rhinocerose/eurorack-jakplugg-nRings/NanoRings BOM 1.0.xlsx

Sheet: Sheet1
Quantity | Value | RefDes | Name | Mouser | Other | Notes
6 | 18p | C4, C5, C23, C24, C42, C43 | C-USC0603 | 81-GRM185C1H180JA01J
1 | 220p | C49 | C-USC0603 | 81-GRM185C1H221GA01D
2 | 2.2n | C14, C29 | C-USC0603 | 81-GRM1885C1H222JA1J
4 | 10n | C26, C28, C36, C38 | C-USC0603 | 81-GRM18R71H103JA01D
20 | 100n | C6, C9, C10, C11, C13, C15, C17, C19, C20, C25, C27, C31, C35, C37, C39, C44, C45, C47, C48, C50 | C-USC0603 | 81-GRM188R71E104JA1J
3 | 1u | C7, C18, C30 | C-USC0603 | 81-GRM18R61A105KA61J
2 | 2.2u | C16, C22 | C-USC0805 | 810-C2012X5R1A225K-2
8 | 10u | C12, C21, C32, C33, C34, C40, C41, C46 | CPOL-USA | 647-UWX1C100MCL2
1 | 22u | C1 | CPOL-USC | 667-EEE-FP1E220AR
3 | 47u | C2, C3, C8 | CPOL-USD | 667-EEE-FT1V470AR
1 | 4.7 | R2 | R-US_R1206 | 603-RC1206JR-074R7L (https://www.mouser.com/ProductDetail/Yageo/RC1206JR-074R7L/)
4 | 180 | R1, R3, R4, R5 | R-US_R0603 | 603-RC0603FR-07180RL (http://www.mouser.com/ProductDetail/Yageo/RC0603FR-07180RL/?qs=sGAEpiMZZMu61qfTUdNhG5eFuApKbqVd4SzxXNqyudw%3d)
2 | 1.0k | R55, R56 | R-US_R0603 | 603-RC0603FR-071KL (http://www.mouser.com/Search/ProductDetail.aspx)
3 | 2.2k | R12, R16, R17 | R-US_R0603 | 603-RC0603FR-072K2L (http://www.mouser.com/ProductDetail/Yageo/RC0603FR-072K2L/)
3 | 6.8k | R40, R43, R51 | R-US_R0603 | 603-RC0603FR-076K8L (http://www.mouser.com/Search/ProductDetail.aspx)
3 | 10k | R6, R7, R8 | R-US_R0603 | 603-RC0603FR-0710KL (http://www.mouser.com/ProductDetail/Yageo/RC0603FR-0710KL/?qs=sGAEpiMZZMu61qfTUdNhGy0AaN4GKk3uV0uhGqAFOnk%3d)
5 | 20k | R18, R25, R26, R31, R32 | R-US_R0603 | 603-RC0603FR-0720KL (http://www.mouser.com/ProductDetail/Yageo/RC0603FR-0720KL/)
2 | 36k | R27, R54 | R-US_R0603 | 603-RC0603FR-0736KL (http://www.mouser.com/ProductDetail/Yageo/RC0603FR-0736KL)
7 | 47k | R13, R33, R38, R39, R41, R42, R44 | R-US_R0603 | 603-RC0603FR-0747KL (http://www.mouser.com/Search/ProductDetail.aspx)
8 | 100k | R11, R14, R19, R21, R22, R34, R35, R52 | R-US_R0603 | 603-RC0603FR-07100KL (http://www.mouser.com/Search/ProductDetail.aspx)
5 | 120k | R20, R23, R24, R36, R37 | R-US_R0603 | 603-RC0603FR-07120KL (http://www.mouser.com/ProductDetail/Yageo/RC0603FR-07120KL/?qs=sGAEpiMZZMu61qfTUdNhG6gKAQVNBKOoUjxHZ2IMUOI%3d)
1 | 180k | R15 | R-US_R0603 | 603-RC0603FR-07180KL (http://www.mouser.com/ProductDetail/Yageo/RC0603FR-07180KL)
1 | 470k | R57 | R-US_R0603 | 603-RC0603FR-07470KL (http://www.mouser.com/ProductDetail/Yageo/RC0603FR-07470KL/)
1 | 1M | R53 | R-US_R0603 | 603-RC0603FR-071ML (http://www.mouser.com/ProductDetail/Yageo/RC0603FR-071ML/?qs=sGAEpiMZZMu61qfTUdNhG5eFuApKbqVd5YtEsnCb1iw%3d)
1 | 3.3M | R50 | R-US_R0603 | RC0603FR-073M3L (http://www.mouser.com/ProductDetail/Yageo/RC0603FR-073M3L/)
5 | 10kB | R45, R46, R47, R48, R49 | POT_USVERTICAL | Sung Huei Short
5 | 10kB | R9, R10, R28, R29, R30 | POT_USVERTICAL_PS | Sung Huei Long
1 | BAT54S | D3 | DIODE_2CACA-SOT23 | 512-BAT54S
1 | MB1S | D7 | MB1S | 512-MB1S
1 | LM1117-3.3 | IC1 | REG1117T | 926-LM1117MPX3.3NOPB
1 | STM32F405RGT6 | IC2 | STM32F20X | 511-STM32F405RGT6
1 | LM4040B10 | IC3 | LM4041B12DBZ | 595-LM4040C10IDBZR
1 | 4051PW | IC4 | 4051PW | 595-CD4051BPWR
3 | MCP6002 | IC5, IC7, IC9 | SOIC8 | 579-MCP6002-I/SN
1 | WM8731 | IC6 | WM8731 | 238-WM8731SEDS/V
1 | TL072 | IC8 | SOIC8 | 595-TL072CD
3 |  | L1, L2, L3 | WE-CBF_0603 | 710-742792642
2 | WP115VEGW | LED1, LED2 | LED-BICOLOR-TH | 604-WP115VEGW
1 | 8MHz | Q1 | TSC 7A crystal | 717-7A-8.000MAAJ-T
1 | MMBT3904 | Q2 | MMBT3904 | 863-MMBT3904LT1G
1 | 12.288MHz | Q3 | TSC 7A crystal | 717-7A-12.288MAAJ-T
2 |  | SW1, SW2 | TAC_SWITCHPTH | 612-TL1105SP-250
2 |  |  | Cap for switch | 612-1R-BK
10 | PJ301 | J1, J2, J3, J4, J5, J6, J7, J8. J9, J10
1 | SOLDERJUMPERNC2 | SJ1 | SOLDERJUMPERNC2
1 | M05X2MINIJTAG | JP1 | M05X2MINIJTAG
1 | M05X2PTH | JP3 | M05X2PTH

Sheet: rangoon
Quantity | Value | RefDes | Name | Mouser | Other | Notes
6 | 18p | C4, C5, C23, C24, C42, C43 | C-USC0603 | 81-GRM185C1H180JA01J
1 | 220p | C49 | C-USC0603 | 81-GRM185C1H221GA01D
2 | 2.2n | C14, C29 | C-USC0603 | 81-GRM1885C1H222JA1J
4 | 10n | C26, C28, C36, C38 | C-USC0603 | 81-GRM18R71H103JA01D
20 | 100n | C6, C9, C10, C11, C13, C15, C17, C19, C20, C25, C27, C31, C35, C37, C39, C44, C45, C47, C48, C50 | C-USC0603 | 81-GRM188R71E104JA1J
3 | 1u | C7, C18, C30 | C-USC0603 | 81-GRM18R61A105KA61J
2 | 2.2u | C16, C22 | C-USC0805 | 810-C2012X5R1A225K-2
8 | 10u | C12, C21, C32, C33, C34, C40, C41, C46 | CPOL-USA | 647-UWX1C100MCL2
1 | 22u | C1 | CPOL-USC | 667-EEE-FP1E220AR
3 | 47u | C2, C3, C8 | CPOL-USD | 667-EEE-FT1V470AR
1 | 4.7 | R2 | R-US_R1206 | 603-RC1206JR-074R7L (https://www.mouser.com/ProductDetail/Yageo/RC1206JR-074R7L/)
4 | 180 | R1, R3, R4, R5 | R-US_R0603 | 603-RC0603FR-07180RL (http://www.mouser.com/ProductDetail/Yageo/RC0603FR-07180RL/?qs=sGAEpiMZZMu61qfTUdNhG5eFuApKbqVd4SzxXNqyudw%3d)
2 | 1.0k | R55, R56 | R-US_R0603 | 603-RC0603FR-071KL (http://www.mouser.com/Search/ProductDetail.aspx)
3 | 2.2k | R12, R16, R17 | R-US_R0603 | 603-RC0603FR-072K2L (http://www.mouser.com/ProductDetail/Yageo/RC0603FR-072K2L/)
3 | 6.8k | R40, R43, R51 | R-US_R0603 | 603-RC0603FR-076K8L (http://www.mouser.com/Search/ProductDetail.aspx)
3 | 10k | R6, R7, R8 | R-US_R0603 | 603-RC0603FR-0710KL (http://www.mouser.com/ProductDetail/Yageo/RC0603FR-0710KL/?qs=sGAEpiMZZMu61qfTUdNhGy0AaN4GKk3uV0uhGqAFOnk%3d)
5 | 20k | R18, R25, R26, R31, R32 | R-US_R0603 | 603-RC0603FR-0720KL (http://www.mouser.com/ProductDetail/Yageo/RC0603FR-0720KL/)
2 | 36k | R27, R54 | R-US_R0603 | 603-RC0603FR-0736KL (http://www.mouser.com/ProductDetail/Yageo/RC0603FR-0736KL)
7 | 47k | R13, R33, R38, R39, R41, R42, R44 | R-US_R0603 | 603-RC0603FR-0747KL (http://www.mouser.com/Search/ProductDetail.aspx)
8 | 100k | R11, R14, R19, R21, R22, R34, R35, R52 | R-US_R0603 | 603-RC0603FR-07100KL (http://www.mouser.com/Search/ProductDetail.aspx)
5 | 120k | R20, R23, R24, R36, R37 | R-US_R0603 | 603-RC0603FR-07120KL (http://www.mouser.com/ProductDetail/Yageo/RC0603FR-07120KL/?qs=sGAEpiMZZMu61qfTUdNhG6gKAQVNBKOoUjxHZ2IMUOI%3d)
1 | 180k | R15 | R-US_R0603 | 603-RC0603FR-07180KL (http://www.mouser.com/ProductDetail/Yageo/RC0603FR-07180KL)
1 | 470k | R57 | R-US_R0603 | 603-RC0603FR-07470KL (http://www.mouser.com/ProductDetail/Yageo/RC0603FR-07470KL/)
1 | 1M | R53 | R-US_R0603 | 603-RC0603FR-071ML (http://www.mouser.com/ProductDetail/Yageo/RC0603FR-071ML/?qs=sGAEpiMZZMu61qfTUdNhG5eFuApKbqVd5YtEsnCb1iw%3d)
1 | 3.3M | R50 | R-US_R0603 | RC0603FR-073M3L (http://www.mouser.com/ProductDetail/Yageo/RC0603FR-073M3L/)
5 | 10kB | R9, R10, R28, R29, R30 | POT_USVERTICAL_PS | Sung Huei Long
5 | 10kB | R45, R46, R47, R48, R49 | POT_USVERTICAL | Sung Huei Short
4 | 10kB |  | 30mm LED slider
1 | BAT54S | D3 | DIODE_2CACA-SOT23 | 512-BAT54S
1 | MB1S | D7 | MB1S | 512-MB1S
1 | LM1117-3.3 | IC1 | REG1117T | 926-LM1117MPX3.3NOPB
1 | STM32F405RGT6 | IC2 | STM32F20X | 511-STM32F405RGT6
1 | LM4040B10 | IC3 | LM4041B12DBZ | 595-LM4040C10IDBZR
1 | 4051PW | IC4 | 4051PW | 595-CD4051BPWR
3 | MCP6002 | IC5, IC7, IC9 | SOIC8 | 579-MCP6002-I/SN
1 | WM8731 | IC6 | WM8731 | 238-WM8731SEDS/V
1 | TL072 | IC8 | SOIC8 | 595-TL072CD
3 |  | L1, L2, L3 | WE-CBF_0603 | 710-742792642
2 | WP115VEGW | LED1, LED2 | LED-BICOLOR-TH | 604-WP115VEGW
1 | 8MHz | Q1 | TSC 7A crystal | 717-7A-8.000MAAJ-T
1 | MMBT3904 | Q2 | MMBT3904 | 863-MMBT3904LT1G
1 | 12.288MHz | Q3 | TSC 7A crystal | 717-7A-12.288MAAJ-T
2 |  | SW1, SW2 | TAC_SWITCHPTH | 612-TL1105SP-250
2 |  |  | Cap for switch | 612-1R-BK
10 | PJ301 | J1, J2, J3, J4, J5, J6, J7, J8. J9, J10
1 | SOLDERJUMPERNC2 | SJ1 | SOLDERJUMPERNC2
1 | M05X2MINIJTAG | JP1 | M05X2MINIJTAG
1 | M05X2PTH | JP3 | M05X2PTH
