rhinocerose/eurorack-jakplugg-nRings/(list of files, drawings)

Other design files:
nrings/board-files/diptrace/nRings.dch
nrings/board-files/diptrace/nRings.dip
nrings/panel/nRings_panel.dip
rangoon/board-files/diptrace/rangoon.dch
rangoon/board-files/diptrace/rangoon.dip
rangoon/panel/PCB_panel_basic/rangoon_panel_plugg.dip
rangoon/panel/rangoon_panel_plugg.dip
