rhinocerose/eurorack-jakplugg-nRings/nrings/board-files/kicad/nrings.kicad_pcb

## KiCad design nrings/board-files/kicad/nrings.kicad_pcb (2025-08-07)

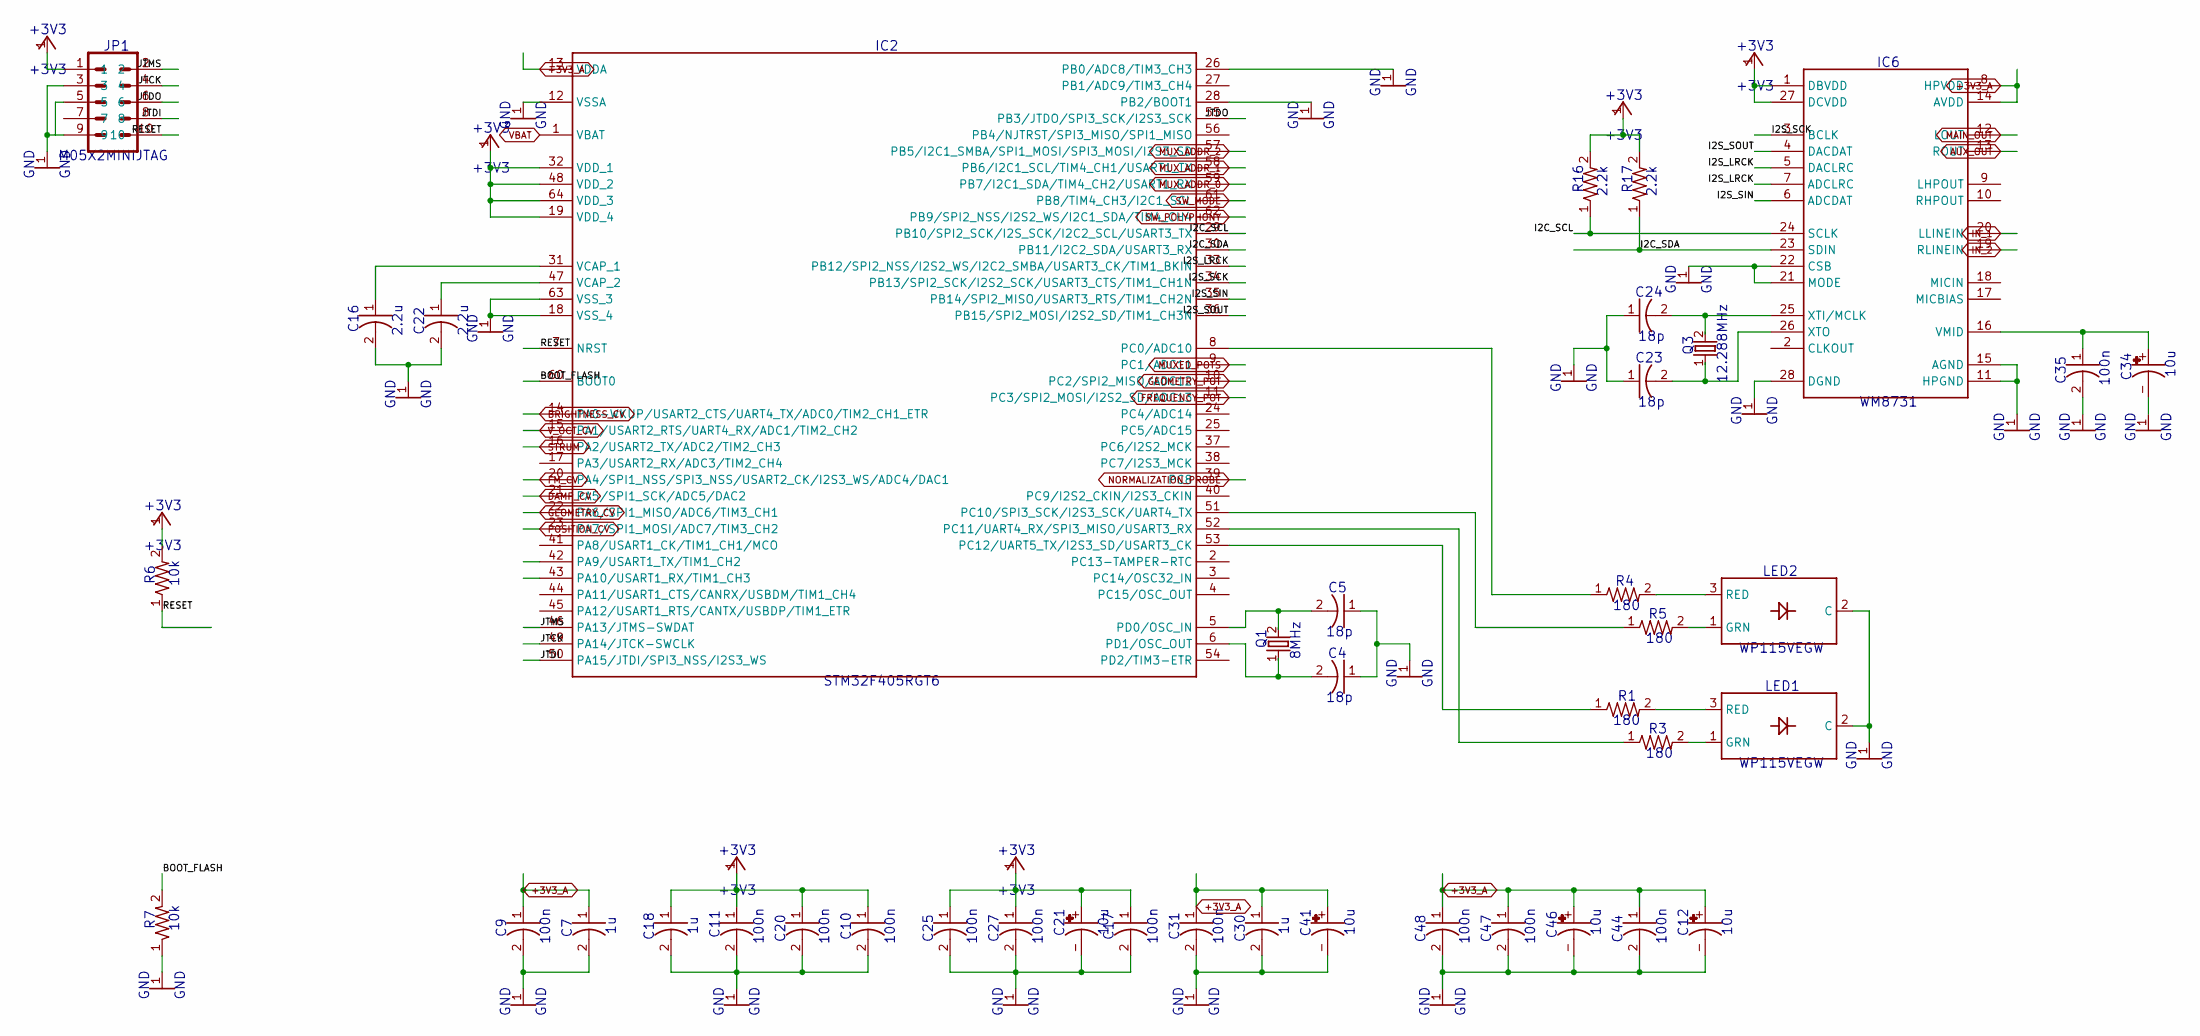
[picture p1: schematic Sheet1.kicad_sch]

Parts:
C4, C5, C23, C24: 18p; CAP_0603
C7, C18, C30: 1u; CAP_0603
C9, C10, C11, C17, C20, C25, C27, C31, C35, C44, C47, C48: 100n; CAP_0603
C12, C21, C34, C41, C46: 10u; PANASONIC_A
C16, C22: 2.2u; CAP_0805
IC2: STM32F405RGT6; TQFP-10X10-64
IC6: WM8731; SSOP28
JP1: M05X2MINIJTAG; 2X5-1.27
LED1, LED2: WP115VEGW; LED-BICOLOR-THROUGHHOLE
Q1: 8MHz; TSC_7A_CRYSTAL
Q3: 12.288MHz; TSC_7A_CRYSTAL
R1, R3, R4, R5: 180; RES_0603
R6, R7: 10k; RES_0603
R16, R17: 2.2k; RES_0603

Connections:
+3V3: C10.1, C11.1, C17.1, C18.1, C20.1, C21.+, C25.1, C27.1, IC2.19 (VDD_4), IC2.32 (VDD_1), IC2.48 (VDD_2), IC2.64 (VDD_3), IC6.1 (DBVDD), IC6.27 (DCVDD), JP1.1, R6.2, R16.2, R17.2; also elsewhere on the board
+3V3_A: C7.1, C9.1, C12.+, C30.1, C31.1, C41.+, C44.1, C46.+, C47.1, C48.1, IC2.13 (VDDA), IC6.8 (HPVDD), IC6.14 (AVDD); also elsewhere on the board
AUX_OUT: IC6.13 (ROUT); also elsewhere on the board
BOOT_FLASH: IC2.60 (BOOT0), R7.2
BRIGHTNESS_CV: IC2.14 (PA0-WKUP/USART2_CTS/UART4_TX/ADC0/TIM2_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); also elsewhere on the board
DAMP_CV: IC2.21 (PA5/SPI1_SCK/ADC5/DAC2); also elsewhere on the board
FM_CV: IC2.20 (PA4/SPI1_NSS/SPI3_NSS/USART2_CK/I2S3_WS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); also elsewhere on the board
FREQUENCY_POT: IC2.11 (PC3/SPI2_MOSI/I2S2_SD/ADC13); also elsewhere on the board
GEOMETRY_CV: IC2.22 (PA6/SPI1_MISO/ADC6/TIM3_CH1); also elsewhere on the board
GEOMETRY_POT: IC2.10 (PC2/SPI2_MISO/ADC12); also elsewhere on the board
GND: C4.1, C5.1, C7.2, C9.2, C10.2, C11.2, C12.-, C16.2, C17.2, C18.2, C20.2, C21.-, C22.2, C23.1, C24.1, C25.2, C27.2, C30.2, C31.2, C34.-, C35.2, C41.-, C44.2, C46.-, C47.2, C48.2, IC2.12 (VSSA), IC2.18 (VSS_4), IC2.26 (PB0/ADC8/TIM3_CH3), IC2.28 (PB2/BOOT1), IC2.63 (VSS_3), IC6.11 (HPGND), IC6.15 (AGND), IC6.21 (MODE), IC6.22 (CSB), IC6.28 (DGND), JP1.3, JP1.5, JP1.9, LED1.2 (C), LED2.2 (C), R7.1; also elsewhere on the board
I2C_SCL: IC2.29 (PB10/SPI2_SCK/I2S_SCK/I2C2_SCL/USART3_TX), IC6.24 (SCLK), R16.1
I2C_SDA: IC2.30 (PB11/I2C2_SDA/USART3_RX), IC6.23 (SDIN), R17.1
I2S_LRCK: IC2.33 (PB12/SPI2_NSS/I2S2_WS/I2C2_SMBA/USART3_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), IC6.5 (DACLRC), IC6.7 (ADCLRC)
I2S_SCK: IC2.34 (PB13/SPI2_SCK/I2S2_SCK/USART3_CTS/TIM1_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), IC6.3 (BCLK)
I2S_SIN: IC2.35 (PB14/SPI2_MISO/USART3_RTS/TIM1_CH2N), IC6.6 (ADCDAT)
I2S_SOUT: IC2.36 (PB15/SPI2_MOSI/I2S2_SD/TIM1_CH3N), IC6.4 (DACDAT)
IN_1: IC6.20 (LLINEIN); also elsewhere on the board
IN_2: IC6.19 (RLINEIN); also elsewhere on the board
JTCK: IC2.49 (PA14/JTCK-SWCLK), JP1.4
JTDI: IC2.50 (PA15/JTDI/SPI3_NSS/I2S3_WS), JP1.8
JTDO: IC2.55 (PB3/JTDO/SPI3_SCK/I2S3_SCK), JP1.6
JTMS: IC2.46 (PA13/JTMS-SWDAT), JP1.2
MAIN_OUT: IC6.12 (LOUT); also elsewhere on the board
MUXED_POTS: IC2.9 (PC1/ADC11); also elsewhere on the board
MUX_ADDR_0: IC2.59 (PB7/I2C1_SDA/TIM4_CH2/USART1_RX); also elsewhere on the board
MUX_ADDR_1: IC2.58 (PB6/I2C1_SCL/TIM4_CH1/USART1_TX); also elsewhere on the board
MUX_ADDR_2: IC2.57 (PB5/I2C1_SMBA/SPI1_MOSI/SPI3_MOSI/I2S3_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); also elsewhere on the board
unnamed: C5.2, IC2.5 (PD0/OSC_IN), Q1.2
unnamed: C4.2, IC2.6 (PD1/OSC_OUT), Q1.1
unnamed: LED1.3 (RED), R1.2
unnamed: C22.1, IC2.47 (VCAP_2)
unnamed: C34.+, C35.1, IC6.16 (VMID)
unnamed: C16.1, IC2.31 (VCAP_1)
unnamed: LED1.1 (GRN), R3.2
unnamed: LED2.3 (RED), R4.2
unnamed: LED2.1 (GRN), R5.2
unnamed: IC2.52 (PC11/UART4_RX/SPI3_MISO/USART3_RX), R3.1
unnamed: IC2.8 (PC0/ADC10), R4.1
unnamed: C24.2, IC6.25 (XTI/MCLK), Q3.2
unnamed: C23.2, IC6.26 (XTO), Q3.1
unnamed: IC2.53 (PC12/UART5_TX/I2S3_SD/USART3_CK), R1.1
unnamed: IC2.51 (PC10/SPI3_SCK/I2S3_SCK/UART4_TX), R5.1
NORMALIZATION_PROBE: IC2.39 (PC8); also elsewhere on the board
POSITION_CV: IC2.23 (PA7/SPI1_MOSI/ADC7/TIM3_CH2); also elsewhere on the board
RESET: IC2.7 (NRST), JP1.10, R6.1
STRUM: IC2.16 (PA2/USART2_TX/ADC2/TIM2_CH3); also elsewhere on the board
SW_MODE: IC2.61 (PB8/TIM4_CH3/I2C1_SCL); also elsewhere on the board
SW_POLYPHONY: IC2.62 (PB9/SPI2_NSS/I2S2_WS/I2C1_SDA/TIM4_CH4); also elsewhere on the board
V_OCT_CV: IC2.15 (PA1/USART2_RTS/UART4_RX/ADC1/TIM2_CH2); also elsewhere on the board

Notes on the sheet:
10u
C21
GND
180
C20
WM8731
C27
C16
C46
STM32F405RGT6
C18
C10
C31
C41
10k
WP115VEGW
C23
C22
LED2
+3V3
100n
8MHz
18p
IC2
M05X2MINIJTAG
JP1
2.2k
IC6
C48
R16
C11
R17
LED1
C12
C17
C47
C25
C44
C24
C30
C35
12.288MHz
2.2u
C34

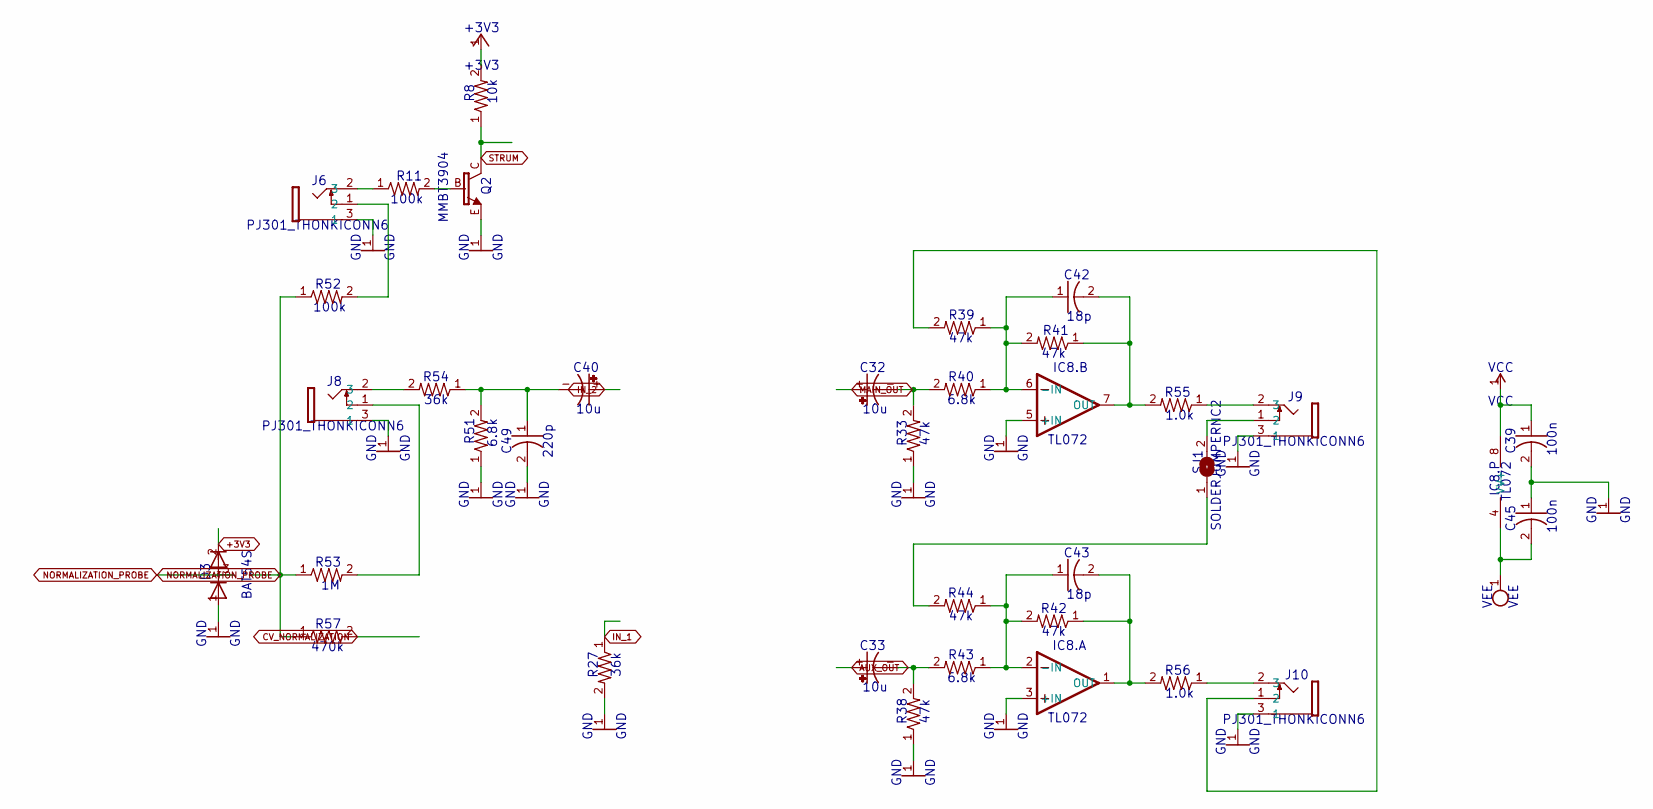
[picture p2: schematic Sheet4.kicad_sch]

Parts:
C32, C33, C40: 10u; PANASONIC_A
C39, C45: 100n; CAP_0603
C42, C43: 18p; CAP_0603
C49: 220p; CAP_0603
D3: BAT54S; SOT23
IC8: TL072; SO08
J6, J8, J9, J10: PJ301_THONKICONN6; THONKICONN
Q2: MMBT3904; SOT23-BEC
R8: 10k; RES_0603
R11, R52: 100k; RES_0603
R27, R54: 36k; RES_0603
R33, R38, R39, R41, R42, R44: 47k; RES_0603
R40, R43, R51: 6.8k; RES_0603
R53: 1M; RES_0603
R55, R56: 1.0k; RES_0603
R57: 470k; RES_0603
SJ1: SOLDERJUMPERNC2; SJ_2S-NOTRACE

Connections:
+3V3: D3.2 (C), R8.2; also elsewhere on the board
AUX_OUT: C33.+; also elsewhere on the board
CV_NORMALIZATION: R57.2; also elsewhere on the board
GND: C39.2, C45.1, C49.2, D3.1 (A), IC8.3 (+IN), IC8.5 (+IN), J6.3 (1), J8.3 (1), J9.3 (1), J10.3 (1), Q2.E, R27.2, R33.1, R38.1, R51.1; also elsewhere on the board
IN_1: R27.1; also elsewhere on the board
IN_2: C40.+; also elsewhere on the board
MAIN_OUT: C32.+; also elsewhere on the board
unnamed: J6.2 (3), R11.1
unnamed: C40.-, C49.1, R51.2, R54.1
unnamed: J6.1 (2), R52.2
unnamed: J8.2 (3), R54.2
unnamed: C33.-, R38.2, R43.2
unnamed: C43.1, IC8.2 (-IN), R42.2, R43.1, R44.1
unnamed: C43.2, IC8.1 (OUT), R42.1, R56.2
unnamed: J10.2 (3), R56.1
unnamed: C32.-, R33.2, R40.2
unnamed: C42.1, IC8.6 (-IN), R39.1, R40.1, R41.2
unnamed: C42.2, IC8.7 (OUT), R41.1, R55.2
unnamed: J9.2 (3), R55.1
unnamed: J8.1 (2), R53.2
unnamed: J10.1 (2), R39.2
unnamed: R44.2, SJ1.1
unnamed: J9.1 (2), SJ1.2
unnamed: Q2.B, R11.2
NORMALIZATION_PROBE: D3.3 (AC), R52.1, R53.1, R57.1; also elsewhere on the board
STRUM: Q2.C, R8.1; also elsewhere on the board
VCC: C39.1, IC8.8 (V+); also elsewhere on the board
VEE: C45.2, IC8.4 (V-); also elsewhere on the board

Notes on the sheet:
GND
1.0k
220p
6.8k
C49
R55
47k
10k
R56
R39
C42
100k
36k
R11
C40
SOLDERJUMPERNC2
R38
470k
SJ1
C33
PJ301_THONKICONN6
+3V3
R54
R40
10u
VEE
R57
R43
R51
R52
MMBT3904
J10
100n
C32
C43
R33
IC8.P
TL072
VCC
18p
R53
R41
IC8.B
BAT54S
R44
C45
R27
C39
IC8.A
R42

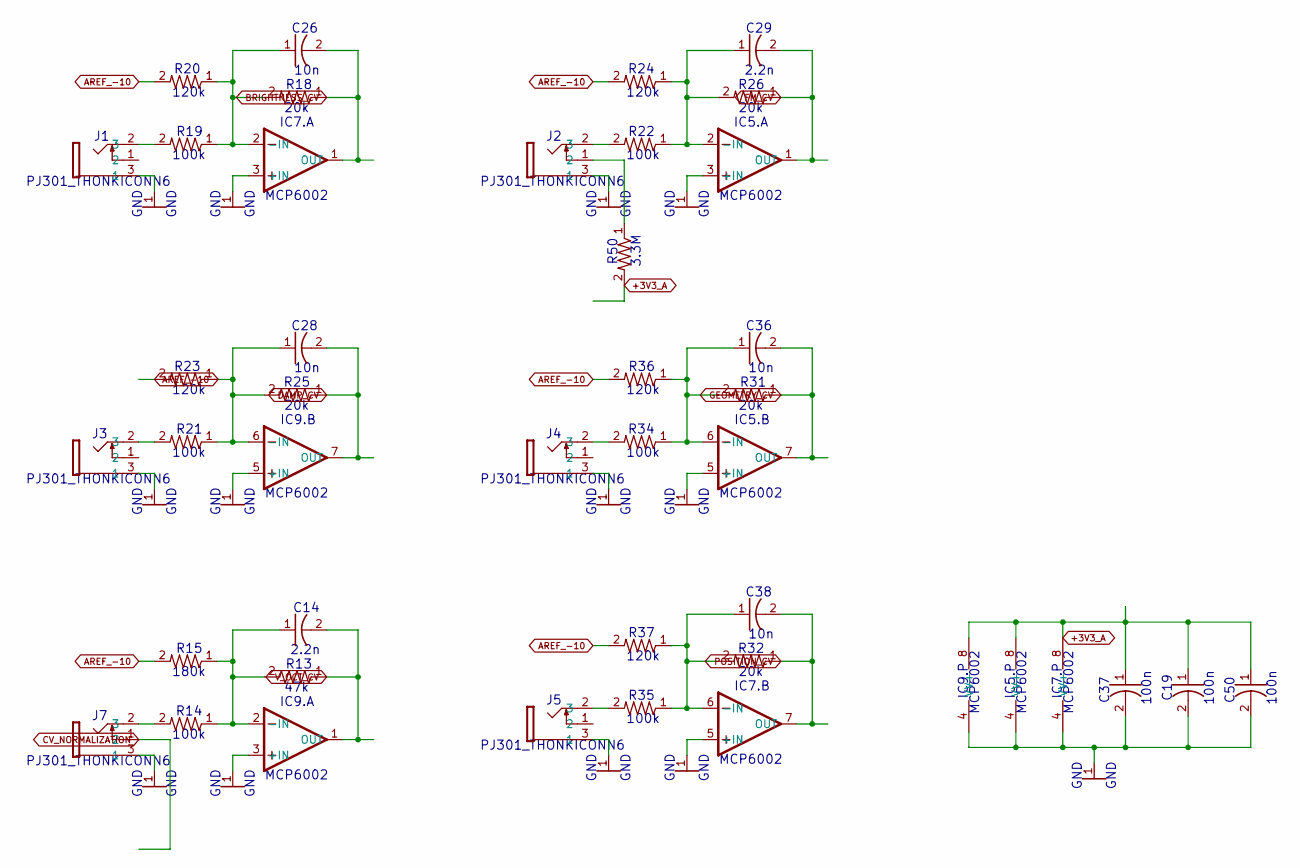
[picture p3: schematic Sheet3.kicad_sch]

Parts:
C14, C29: 2.2n; CAP_0603
C19, C37, C50: 100n; CAP_0603
C26, C28, C36, C38: 10n; CAP_0603
IC5, IC7, IC9: MCP6002; SO08
J1, J2, J3, J4, J5, J7: PJ301_THONKICONN6; THONKICONN
R13: 47k; RES_0603
R14, R19, R21, R22, R34, R35: 100k; RES_0603
R15: 180k; RES_0603
R18, R25, R26, R31, R32: 20k; RES_0603
R20, R23, R24, R36, R37: 120k; RES_0603
R50: 3.3M; RES_0603

Connections:
+3V3_A: C19.1, C37.1, C50.1, IC5.8 (V+), IC7.8 (V+), IC9.8 (V+), R50.2; also elsewhere on the board
AREF_-10: R15.2, R20.2, R23.2, R24.2, R36.2, R37.2; also elsewhere on the board
BRIGHTNESS_CV: C26.2, IC7.1 (OUT), R18.1; also elsewhere on the board
CV_NORMALIZATION: J7.1 (2); also elsewhere on the board
DAMP_CV: C28.2, IC9.7 (OUT), R25.1; also elsewhere on the board
FM_CV: C29.2, IC5.1 (OUT), R26.1; also elsewhere on the board
GEOMETRY_CV: C36.2, IC5.7 (OUT), R31.1; also elsewhere on the board
GND: C19.2, C37.2, C50.2, IC5.3 (+IN), IC5.4 (V-), IC5.5 (+IN), IC7.3 (+IN), IC7.4 (V-), IC7.5 (+IN), IC9.3 (+IN), IC9.4 (V-), IC9.5 (+IN), J1.3 (1), J2.3 (1), J3.3 (1), J4.3 (1), J5.3 (1), J7.3 (1); also elsewhere on the board
unnamed: J1.2 (3), R19.2
unnamed: C26.1, IC7.2 (-IN), R18.2, R19.1, R20.1
unnamed: J7.2 (3), R14.2
unnamed: J2.2 (3), R22.2
unnamed: C29.1, IC5.2 (-IN), R22.1, R24.1, R26.2
unnamed: J4.2 (3), R34.2
unnamed: J3.2 (3), R21.2
unnamed: C28.1, IC9.6 (-IN), R21.1, R23.1, R25.2
unnamed: C14.1, IC9.2 (-IN), R13.2, R14.1, R15.1
unnamed: C36.1, IC5.6 (-IN), R31.2, R34.1, R36.1
unnamed: J5.2 (3), R35.2
unnamed: C38.1, IC7.6 (-IN), R32.2, R35.1, R37.1
unnamed: J2.1 (2), R50.1
POSITION_CV: C38.2, IC7.7 (OUT), R32.1; also elsewhere on the board
V_OCT_CV: C14.2, IC9.1 (OUT), R13.1; also elsewhere on the board

Notes on the sheet:
R31
10n
20k
MCP6002
IC9.B
GND
PJ301_THONKICONN6
2.2n
C50
R20
IC7.P
100k
C26
C29
3.3M
R50
C28
R24
100n
47k
C19
120k
IC7.B
IC5.P
R18
R14
C14
R25
R26
R19
C37
R15
IC9.A
IC5.A
R37
R21
IC9.P
R22
R35
R32
R36
R13
R34
R23
IC7.A
IC5.B
C38
180k
C36

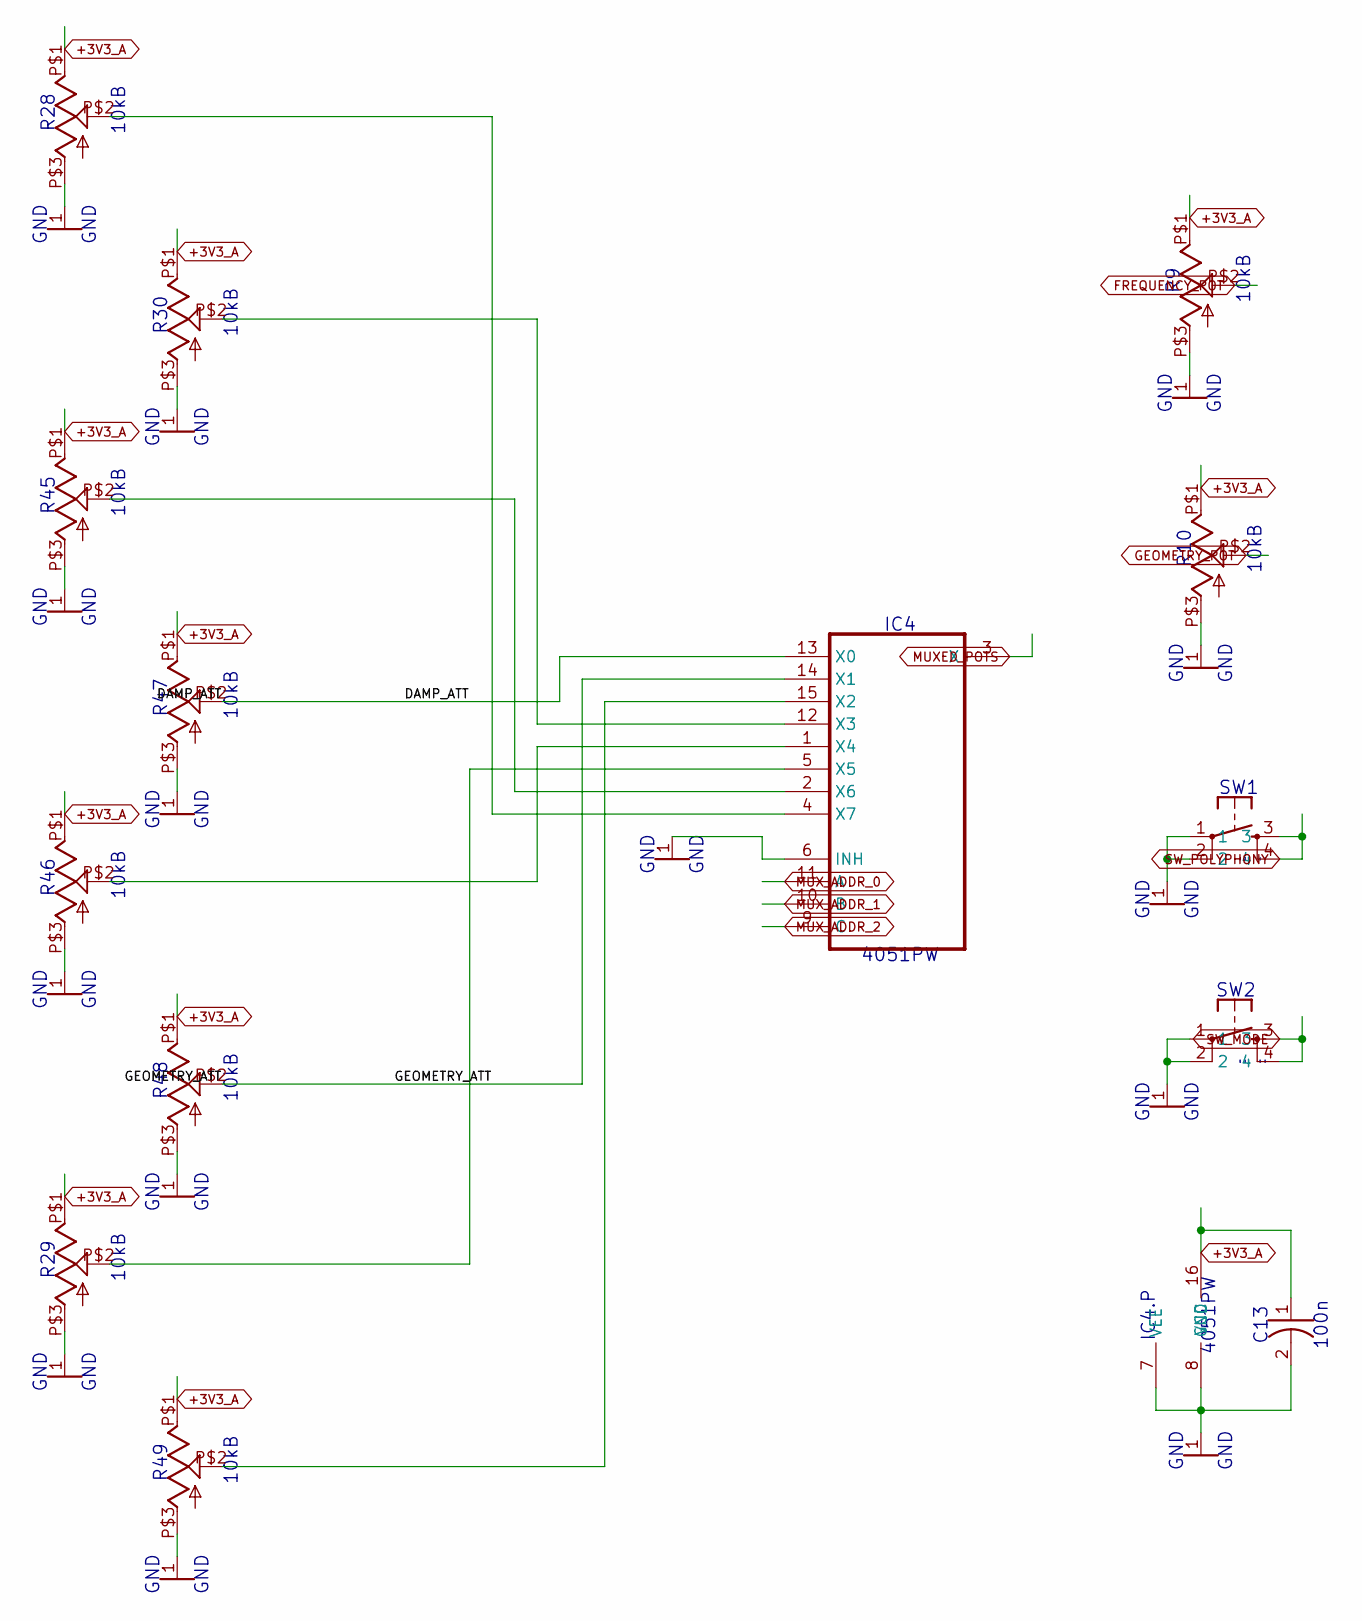
[picture p4: schematic Sheet2.kicad_sch]

Parts:
C13: 100n; CAP_0603
IC4: 4051PW; TSSOP16
R9, R10, R28, R29, R30: 10kB; ALPS_POT_VERTICAL_PS
R45, R46, R47, R48, R49: 10kB; ALPS_POT_VERTICAL
SW1, SW2: TAC_SWITCHPTH; TACTILE-PTH

Connections:
+3V3_A: C13.1, IC4.16 (VCC), R9.P$1 (E), R10.P$1 (E), R28.P$1 (E), R29.P$1 (E), R30.P$1 (E), R45.P$1 (E), R46.P$1 (E), R47.P$1 (E), R48.P$1 (E), R49.P$1 (E); also elsewhere on the board
BRIGHTNESS_ATT: IC4.2 (X6), R45.P$2 (S)
BRIGHTNESS_POT: IC4.4 (X7), R28.P$2 (S)
DAMP_ATT: IC4.13 (X0), R47.P$2 (S)
DAMP_POT: IC4.5 (X5), R29.P$2 (S)
FREQUENCY_ATT: IC4.1 (X4), R46.P$2 (S)
FREQUENCY_POT: R9.P$2 (S); also elsewhere on the board
GEOMETRY_ATT: IC4.14 (X1), R48.P$2 (S)
GEOMETRY_POT: R10.P$2 (S); also elsewhere on the board
GND: C13.2, IC4.6 (INH), IC4.7 (VEE), IC4.8 (GND), R9.P$3 (A), R9.P$4, R9.P$5, R10.P$3 (A), R10.P$4, R10.P$5, R28.P$3 (A), R28.P$4, R28.P$5, R29.P$3 (A), R29.P$4, R29.P$5, R30.P$3 (A), R30.P$4, R30.P$5, R45.P$3 (A), R45.P$4, R45.P$5, R46.P$3 (A), R46.P$4, R46.P$5, R47.P$3 (A), R47.P$4, R47.P$5, R48.P$3 (A), R48.P$4, R48.P$5, R49.P$3 (A), R49.P$4, R49.P$5, SW1.1, SW1.2, SW2.1, SW2.2; also elsewhere on the board
MUXED_POTS: IC4.3 (X); also elsewhere on the board
MUX_ADDR_0: IC4.11 (A); also elsewhere on the board
MUX_ADDR_1: IC4.10 (B); also elsewhere on the board
MUX_ADDR_2: IC4.9 (C); also elsewhere on the board
POSITION_ATT: IC4.15 (X2), R49.P$2 (S)
POSITION_POT: IC4.12 (X3), R30.P$2 (S)
SW_MODE: SW2.3, SW2.4; also elsewhere on the board
SW_POLYPHONY: SW1.3, SW1.4; also elsewhere on the board

Notes on the sheet:
10kB
GND
R28
R48
R49
C13
R45
" "
R47
100n
R46
4051PW
SW1
R29
IC4
IC4.P
R30
R10
SW2

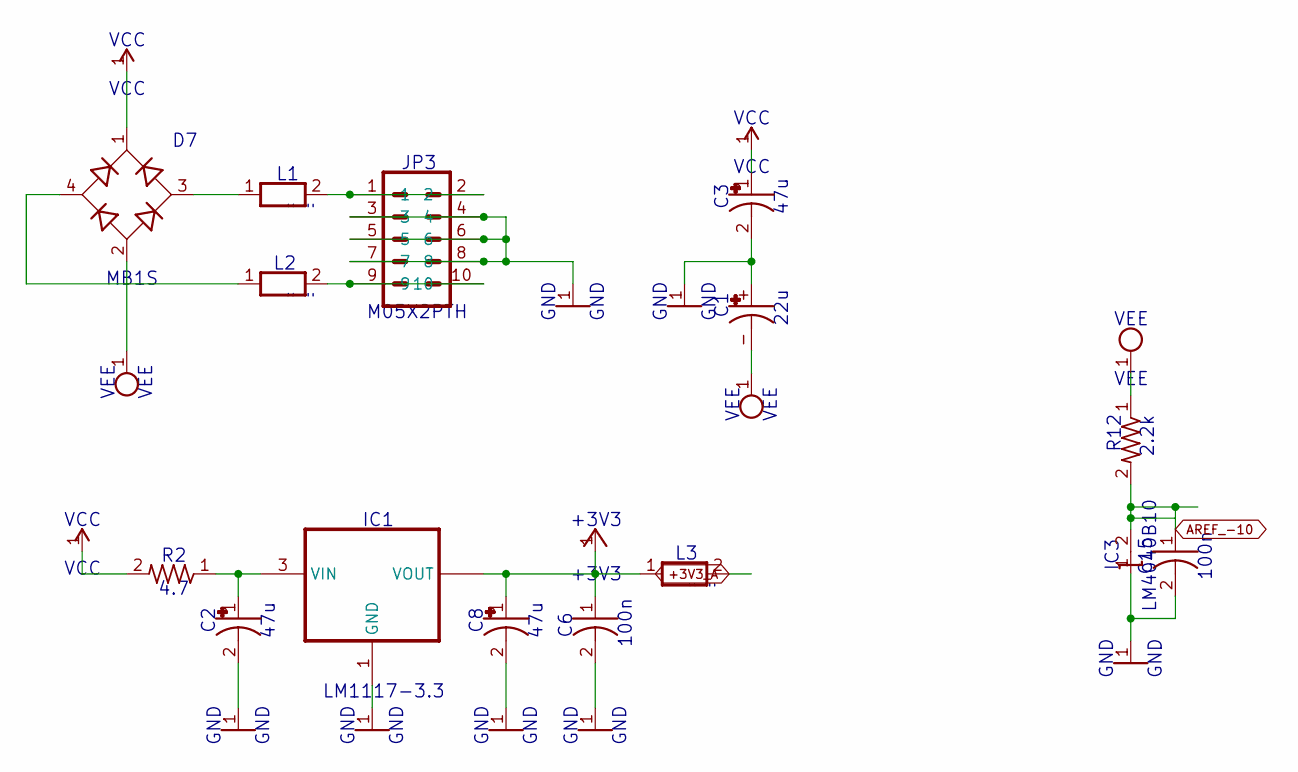
[picture p5: schematic Sheet5.kicad_sch]

Parts:
C1: 22u; PANASONIC_C
C2, C3, C8: 47u; CAPAE-5.3X5.3H7
C6, C15: 100n; CAP_0603
D7: MB1S; SOP-4_6.5X2.54
IC1: LM1117-3.3; SOT223-4
IC3: LM4040B10; DBZ_R-PDSO-G3
JP3: M05X2PTH; AVR_ICSP
L1, L2, L3: WE-CBF_0603; 0603
R2: 4.7; R1206
R12: 2.2k; RES_0603

Connections:
+3V3: C6.1, C8.1 (+), IC1.2 (VOUT), IC1.4 (VOUT), L3.1; also elsewhere on the board
+3V3_A: L3.2; also elsewhere on the board
AREF_-10: C15.1, IC3.2 (A), R12.2; also elsewhere on the board
GND: C1.+, C2.2 (-), C3.2 (-), C6.2, C8.2 (-), C15.2, IC1.1 (GND), IC3.1 (C), JP3.3, JP3.4, JP3.5, JP3.6, JP3.7, JP3.8; also elsewhere on the board
unnamed: C2.1 (+), IC1.3 (VIN), R2.1
unnamed: JP3.1, JP3.2, L1.2
unnamed: JP3.9, JP3.10, L2.2
Net_95: D7.3 (AC2), L1.1
Net_96: D7.4 (AC1), L2.1
VCC: C3.1 (+), D7.1 (+), R2.2; also elsewhere on the board
VEE: C1.-, D7.2 (-), R12.1; also elsewhere on the board

Notes on the sheet:
GND
LM4040B10
47u
+3V3
" "
VEE
100n
R12
C15
MB1S
VCC
2.2k
JP3
IC3
22u
IC1
LM1117-3.3
M05X2PTH
4.7

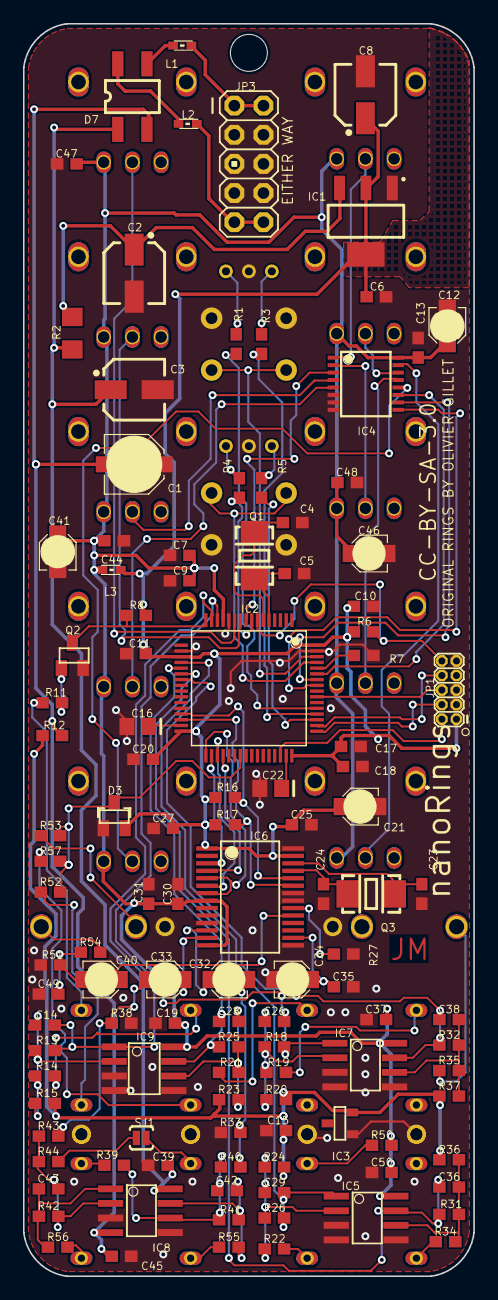
[picture p6: board nrings.kicad_pcb from above]

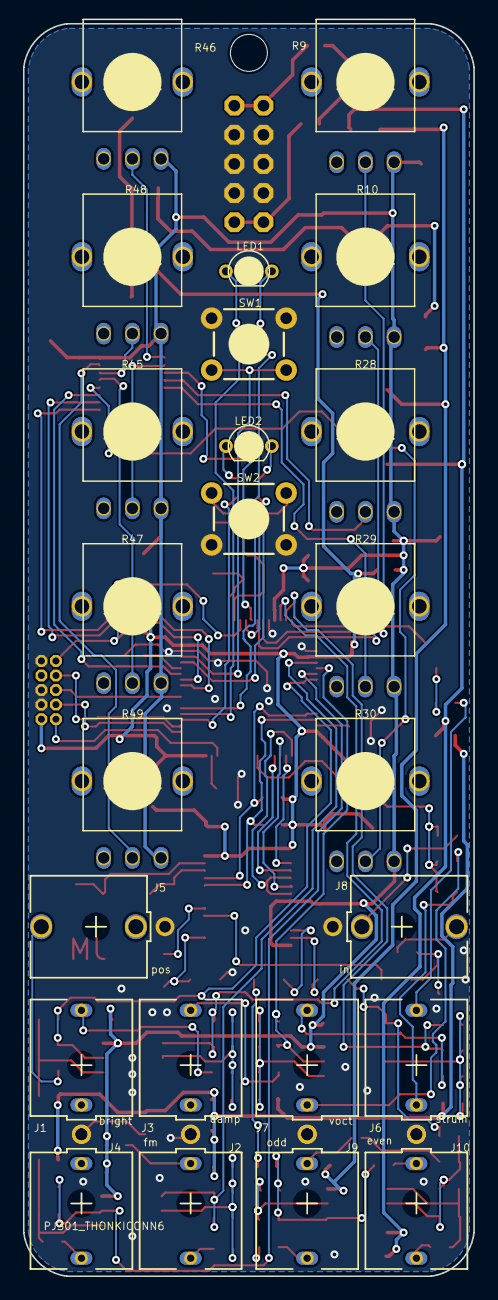
[picture p7: board nrings.kicad_pcb from below]

Board: 2 copper layers, 39.3 x 109.2 mm, 142 parts (24 on the bottom side), 97 nets.

Other parts of the board:
@HOLE0: (no value)
