rhinocerose/eurorack-jakplugg-nRings/(notices)

Notices in the files:
nrings/board-files/eagle/nrings.brd:
CC-BY-SA-3.0
